AhmWael/Laberinto-Maze-Solving-Robot/Supplementary Codes/Shaghal_3_Mapping/Movement_Functions.ino

void MoveWheels (bool dir_l, int speed_l, bool dir_r, int speed_r, String to_print) {
  digitalWrite(l_dir, !(dir_l));
  analogWrite(l_pwm, speed_l);
  digitalWrite(r_dir, !(dir_r));
  analogWrite(r_pwm, speed_r);
  //Serial.println(to_print);
}



void Move(char movement_dir) {
  read_all_TOFs();
  if (movement_dir == 'F') {
    last_blue = false;
//    if (robot_dir == 0) {
//      y_maze += 2;
//      y_max = max(y_max, y_maze);
//    }
//    else if (robot_dir == 1) {
//      x_maze += 2;
//      x_max = max(x_max, x_maze);
//    }
//    else if (robot_dir == 2) {
//      y_maze -= 2;
//      y_min = min(y_min, y_maze);
//    }
//    else {
//      x_maze -= 2;
//      x_min = min(x_min, x_maze);
//    }
    while ((((posir + posil2) / 2) <= (tile_length * 1)) && (TOF_C > 70)) {
      read_all_TOFs();
      read_Cameras();
      if (isBlack()) {
        if (robot_dir == 0) {
          y_maze += 2;
//          y_max = max(y_max, y_maze);
        }
        else if (robot_dir == 1) {
          x_maze += 2;
//          x_max = max(x_max, x_maze);
        }
        else if (robot_dir == 2) {
          y_maze -= 2;
//          y_min = min(y_min, y_maze);
        }
        else {
          x_maze -= 2;
//          x_min = min(x_min, x_maze);
        }
        maze[x_maze][y_maze] = 'B';
        maze[x_maze][y_maze + 1] = '#';
        maze[x_maze + 1][y_maze] = '#';
        maze[x_maze][y_maze - 1] = '#';
        maze[x_maze - 1][y_maze] = '#';
        while (((posir + posil2) / 2) > 0) {
          MoveWheels(LOW, 200, LOW, 200, "Back");
        }
        Move('R');
        Move('R');
        if (robot_dir == 0) {
          y_maze -= 2;
          y_min = min(y_min, y_maze);
        }
        else if (robot_dir == 1) {
          x_maze -= 2;
          x_min = min(x_min, x_maze);
        }
        else if (robot_dir == 2) {
          y_maze += 2;
          y_max = max(y_max, y_maze);
        }
        else {
          x_maze += 2;
          x_max = max(x_max, x_maze);
        }

         return ;
      }
      if (TOF_R < 70)
      {
        int temp_posil = posil2;
        int temp_posir = posir;
        while (TOF_R < 85) {
          MoveWheels(LOW, 200, HIGH, 200, "Left");//LOW, 200, HIGH, 200, "Left"

          read_all_TOFs();
          read_Cameras();
        }
        posir = temp_posir;
        posil2 = temp_posil;
        //        pwm_L = max(94, 94 + ((TOF_R - 35) / 50.0) * 80.0);
        //        pwm_R = min(254, 254 - ((TOF_R - 35) / 50.0) * 54.0);
      }
      else if ((TOF_R >= 85) && (TOF_R <= 105))//135
      {
        pwm_L = max(174, 174 + ((TOF_R - 85) / 50.0) * 80.0);
        pwm_R = max(200, 200 - ((TOF_R - 85) / 50.0) * 54.0);
        //        Serial.println("Here 1");
      }
      else if ((TOF_R > 105) && (TOF_R <= 200))//135    200
      {
        pwm_L = 250;
        pwm_R = 174;
        //        Serial.println("Here 2");
      }
      else {
        pwm_R = 200;
        pwm_L = 193;
      }
      MoveWheels(HIGH, pwm_L, HIGH, pwm_R, "Forward");//HIGH, pwm_L, HIGH, pwm_R, "Forward"

      //      Serial.print("TOF_C:");
      //      Serial.print(TOF_C);
      //      Serial.print("\tTOF_R:");
      //      Serial.print(TOF_R);
      //      Serial.print("\t");
      //      Serial.print("Left PWM: ");
      //      Serial.print(pwm_L);
      //      Serial.print("     ");
      //      Serial.print("Right PWM: ");
      //      Serial.print(pwm_R);
      //      Serial.println();
      //      Serial.print("posil : ");
      //      Serial.print(posil);
      //      Serial.print("\tposir : ");
      //      Serial.println(posir);
    }
    //    Serial.println("##################################");
    timer = millis();
    //      Serial.print(millis());
    //      Serial.print("\t");
    //      Serial.println(timer);
    while (millis() - timer <= 500) {
      read_all_TOFs();
      //read_Cameras();
      MoveWheels(LOW, 0, LOW, 0, "Stop");

    }
    //    Serial.println("New Tile Reached");
    general_pwm = -1;
    //    Serial.print("posir: ");
    //    Serial.print(posir);
    //    Serial.print("\tposil: ");
    //    Serial.println(posil);
    if (((posir + posil2) / 2) < (tile_length * 7 / 8)) {
      return ;
    }
    if (robot_dir == 0) {
      y_maze += 2;
      y_max = max(y_max, y_maze);
    }
    else if (robot_dir == 1) {
      x_maze += 2;
      x_max = max(x_max, x_maze);
    }
    else if (robot_dir == 2) {
      y_maze -= 2;
      y_min = min(y_min, y_maze);
    }
    else {
      x_maze -= 2;
      x_min = min(x_min, x_maze);
    }
    tile_length = 1000;
    posir = 0;
    posil = 0;
    //tile ++;
  }
  else if (movement_dir == 'R') {
    tile_length = 1000;
    posir = 0;
    posil = 0;
    while (abs(posir - posil) <= 2800) {//2750
      MoveWheels(HIGH, 200, LOW, 200, "Right");//HIGH, 200, LOW, 200, "Right"

      //      Serial.print("TOF_C:");
      //      Serial.print(TOF_C);
      //      Serial.print("\tTOF_R:");
      //      Serial.println(TOF_R);

    }
    timer = millis();
    //      Serial.print(millis());
    //      Serial.print("\t");
    //      Serial.println(timer);
    while (millis() - timer <= 500) {
      read_all_TOFs();
      //      read_Cameras();
      MoveWheels(LOW, 0, LOW, 0, "Stop");

    }
    //    Serial.println("##################################");
    //    Serial.println("New Tile Reached");
    tile_length = 1200;
    posir = 0;
    posil = 0;
    robot_dir = (robot_dir + 1) % 4;
  }
  else {
    while (abs(posir - posil) <= 2850) {//2750
      MoveWheels(LOW, 200, HIGH, 200, "Left");//LOW, 200, HIGH, 200, "Left"

      //      Serial.print("TOF_C:");
      //      Serial.print(TOF_C);
      //      Serial.print("\tTOF_R:");
      //      Serial.println(TOF_R);

    }
    timer = millis();
    //      Serial.print(millis());
    //      Serial.print("\t");
    //      Serial.println(timer);
    while (millis() - timer <= 500) {
      read_all_TOFs();
      read_Cameras();
      MoveWheels(LOW, 0, LOW, 0, "Stop");

    }
    //    Serial.println("##################################");
    //    Serial.println("New Tile Reached");
    tile_length = 1100;
    posir = 0;
    posil = 0;
    robot_dir = (robot_dir + 3) % 4;
  }
}
