AhmWael/Laberinto-Maze-Solving-Robot/Supplementary Codes/Nano_Color_Code/Nano_Color_Code.ino

#include "Adafruit_APDS9960.h"
Adafruit_APDS9960 apds;
int signal1 = 7 ;
int signal2 = 4 ;

void setup() {
  Serial.begin(115200);
  pinMode (signal1, OUTPUT);
  pinMode (signal2, OUTPUT);
  //
  if (!apds.begin()) {
    Serial.println("failed to initialize device! Please check your wiring.");
  }
  Serial.println("Device initialized!");

  //enable color sensign mode
  apds.enableColor(true);

}
void loop() {
  //create some variables to store the color data in
  uint16_t r, g, b, c;

  //wait for color data to be ready
  while (!apds.colorDataReady()) {
    delay(5);
  }

  //get the data and print the different channels
  apds.getColorData(&r, &g, &b, &c);
  Serial.print("red: ");
  Serial.print(r);

  Serial.print(" green: ");
  Serial.print(g);

  Serial.print(" blue: ");
  Serial.print(b);

  Serial.print(" clear: ");
  Serial.println(c);
  Serial.println();

  //  digitalWrite(signal1, HIGH);
  //  digitalWrite(signal2, HIGH);
  //  delay(1000);
  //  digitalWrite(signal1, LOW);
  //  digitalWrite(signal2, LOW);
  //  delay(1000);
  //  digitalWrite(signal1, LOW);
  //  digitalWrite(signal2, HIGH);
  //  delay(1000);
  //  digitalWrite(signal1, HIGH);
  //  digitalWrite(signal2, LOW);
  //  delay(1000);
  if ((r < 90) && (g < 90) && (b < 90))
  {
    Serial.println(" BLACK Detected: ");
    digitalWrite(signal1, HIGH);
    digitalWrite(signal2, HIGH);
  }

//  else if ((int(b - r) >= 50) && (int(b - g) >= 50) && (b > 150))
//  {
//    Serial.print("b-r : ");
//    Serial.print(int(b - r));
//    Serial.print("\tb-g : ");
//    Serial.println(int(b - g));
//    Serial.println(" BLUE Detected: ");
//    digitalWrite(signal1, LOW);
//    digitalWrite(signal2, HIGH);
//  }
  else if (r < 100 && g < 120 && b < 185)
  {
//    Serial.print("b-r : ");
//    Serial.print(int(b - r));
//    Serial.print("\tb-g : ");
//    Serial.println(int(b - g));
    Serial.println(" BLUE Detected: ");
    digitalWrite(signal1, LOW);
    digitalWrite(signal2, HIGH);
  }

  else
  {
    Serial.println(" WHITE Detected: ");
    digitalWrite(signal1, LOW);
    digitalWrite(signal2, LOW);
  }
  //  delay(500);
  //  int red = digitalRead(r);
  //  int blue = digitalRead(b);
  //  int green = digitalRead(g);
  //  if (r>b&&r>g){
  //    digitalWrite(signal1,HIGH);
  //    digitalWrite(signal2,LOW);
  //    delay(5000);
  //    digitalWrite(signal1,LOW);
  //  }
  // else if (g>r&&g>b){
  //     digitalWrite(signal2,HIGH);
  //     digitalWrite(signal1,LOW);
  //     delay(5000);
  //     digitalWrite(signal2,LOW);
  //
  //  }
  //  else {
  //    digitalWrite(signal2,LOW);
  //    digitalWrite(signal1,LOW);
  //  }
}
