AhmWael/Laberinto-Maze-Solving-Robot/(commit log)

2023-02-05 Working Code
    Wall following, Camera Detection
2023-02-10 Camera Added
2023-06-18 Updated TOF configuration
    applied the new 5 TOFs configuration in setup and readings and removed some IR obstacle avoidance sensors usage
    [Laberinto_Arduino_Mega_Code.ino, Mapping_Functions.ino, Movement_Functions.ino, TOF_Functions.ino]
2023-06-18 added IMU and new color sensor
    We now use a new arduino nano (2040) so we
    -Added usage of the builtin IMU for accurate 90 degree turns and checking the presence of ramp.
    -Added push buttons for color calibration.
    -Added SPI communication with the arduino mega.
